vojtechsisma/vmix-tally/case/tally3_foot.stl

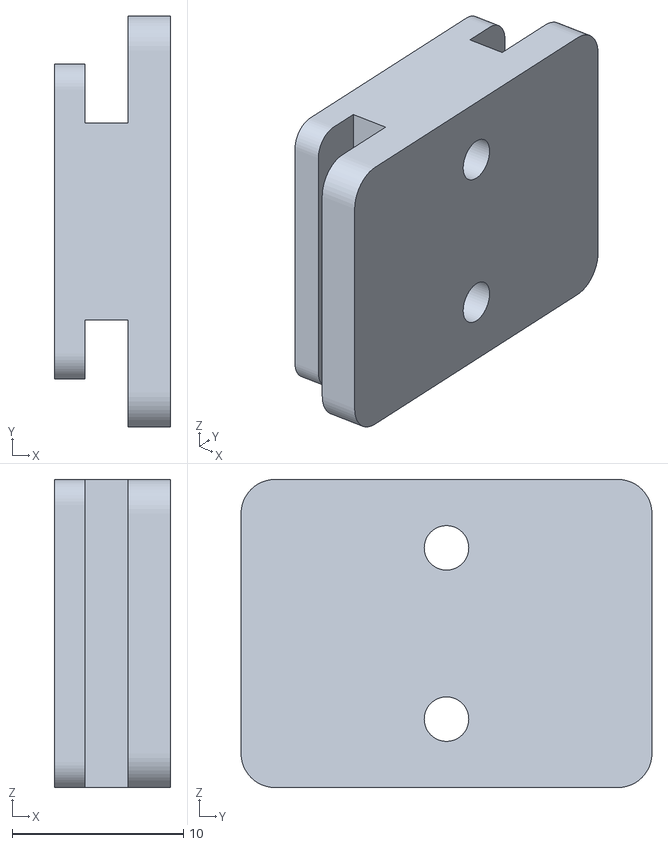
[picture p2: CAD file, 2026-11-11]
case/tally3_foot.stl
6.79 x 24.0 x 18.0
