vojtechsisma/vmix-tally/case/tally3_box.stl

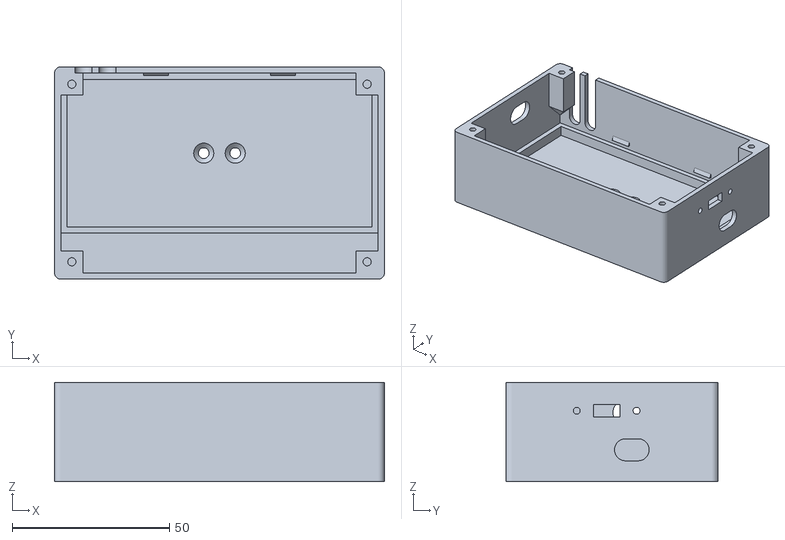
[picture p3: CAD file, 2026-11-11]
case/tally3_box.stl
104.8 x 67.4 x 31.5
