vojtechsisma/vmix-tally/case/tally3_lid.stl

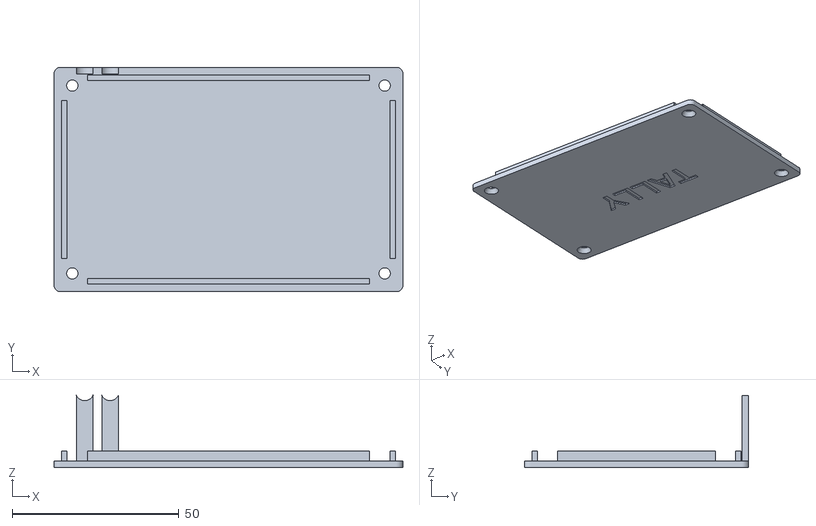
[picture p4: CAD file, 2026-11-11]
case/tally3_lid.stl
104.8 x 67.4 x 21.8
