vojtechsisma/vmix-tally/schematics/vmix_tally_18650.pdf

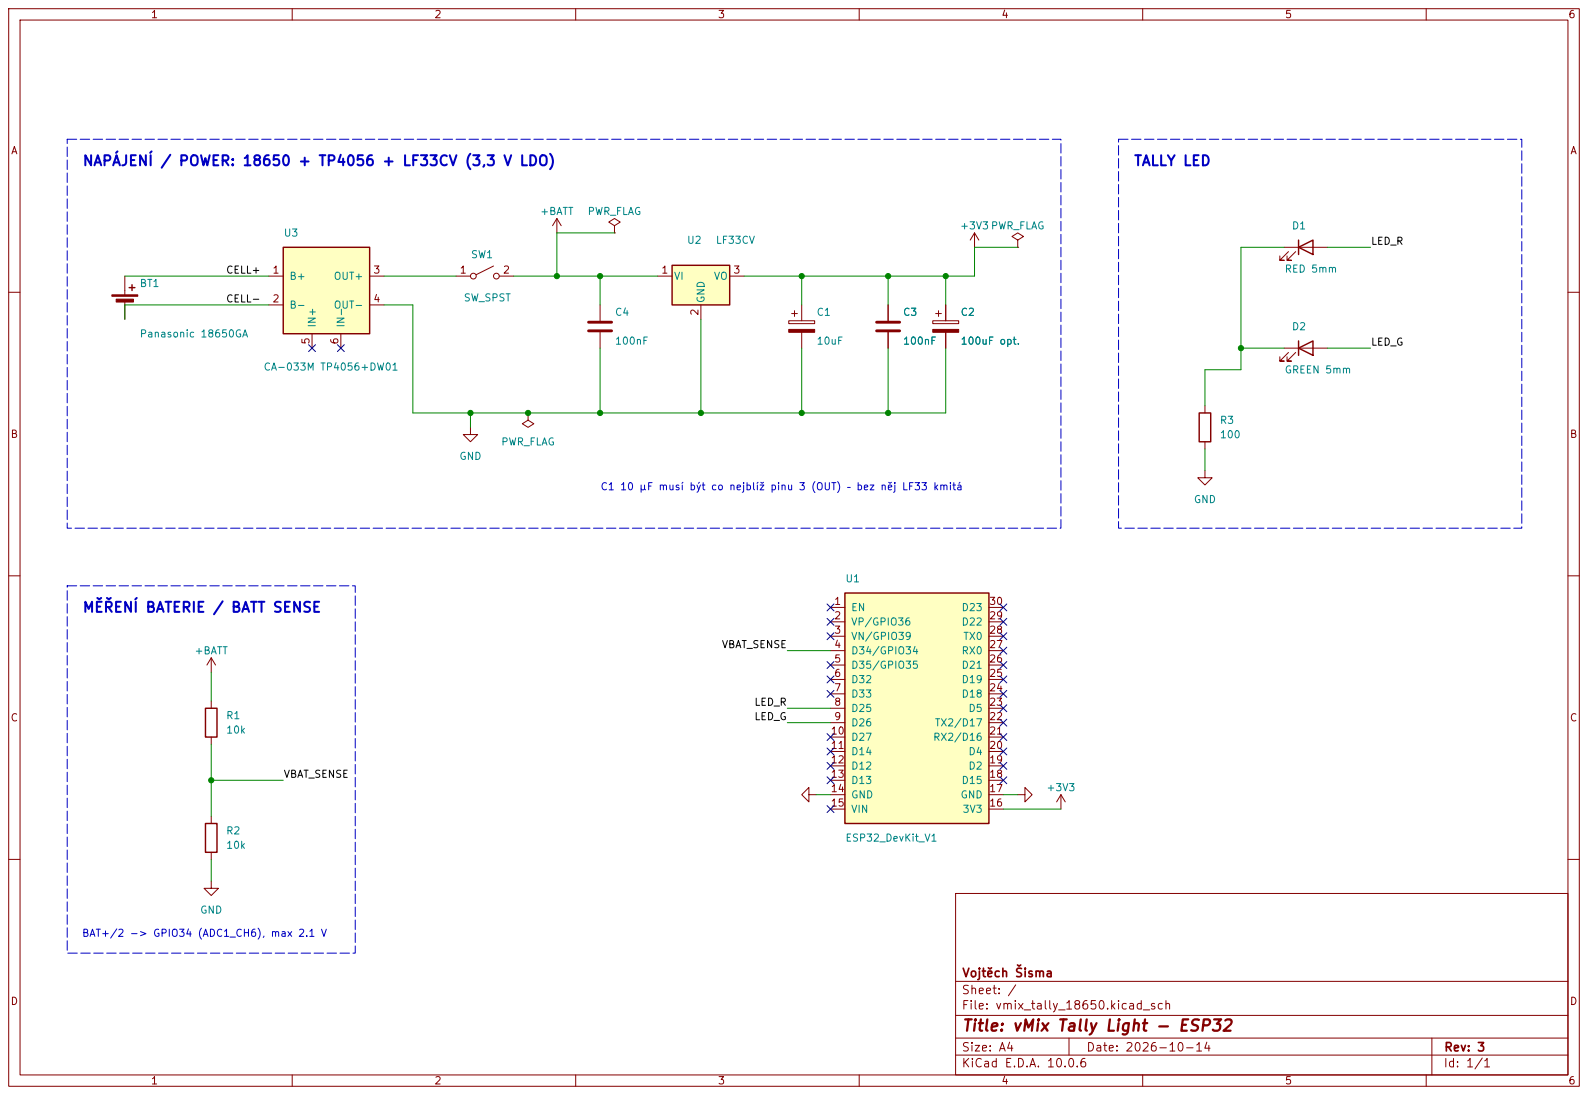
[picture p5: page 1]

MĚŘENÍ BATERIE / BATT SENSE

Vojtěch Šisma
Sheet: /
File: vmix_tally_18650.kicad_sch
Title: vMix Tally Light - ESP32

Size: A4 | Rev: 3
KiCad E.D.A. 10.0.6 | Id: 1/1
