vojtechsisma/vmix-tally/schematics/vmix_tally_18650.kicad_pcb

## KiCad design schematics/vmix_tally_18650.kicad_pcb (2026-10-14)

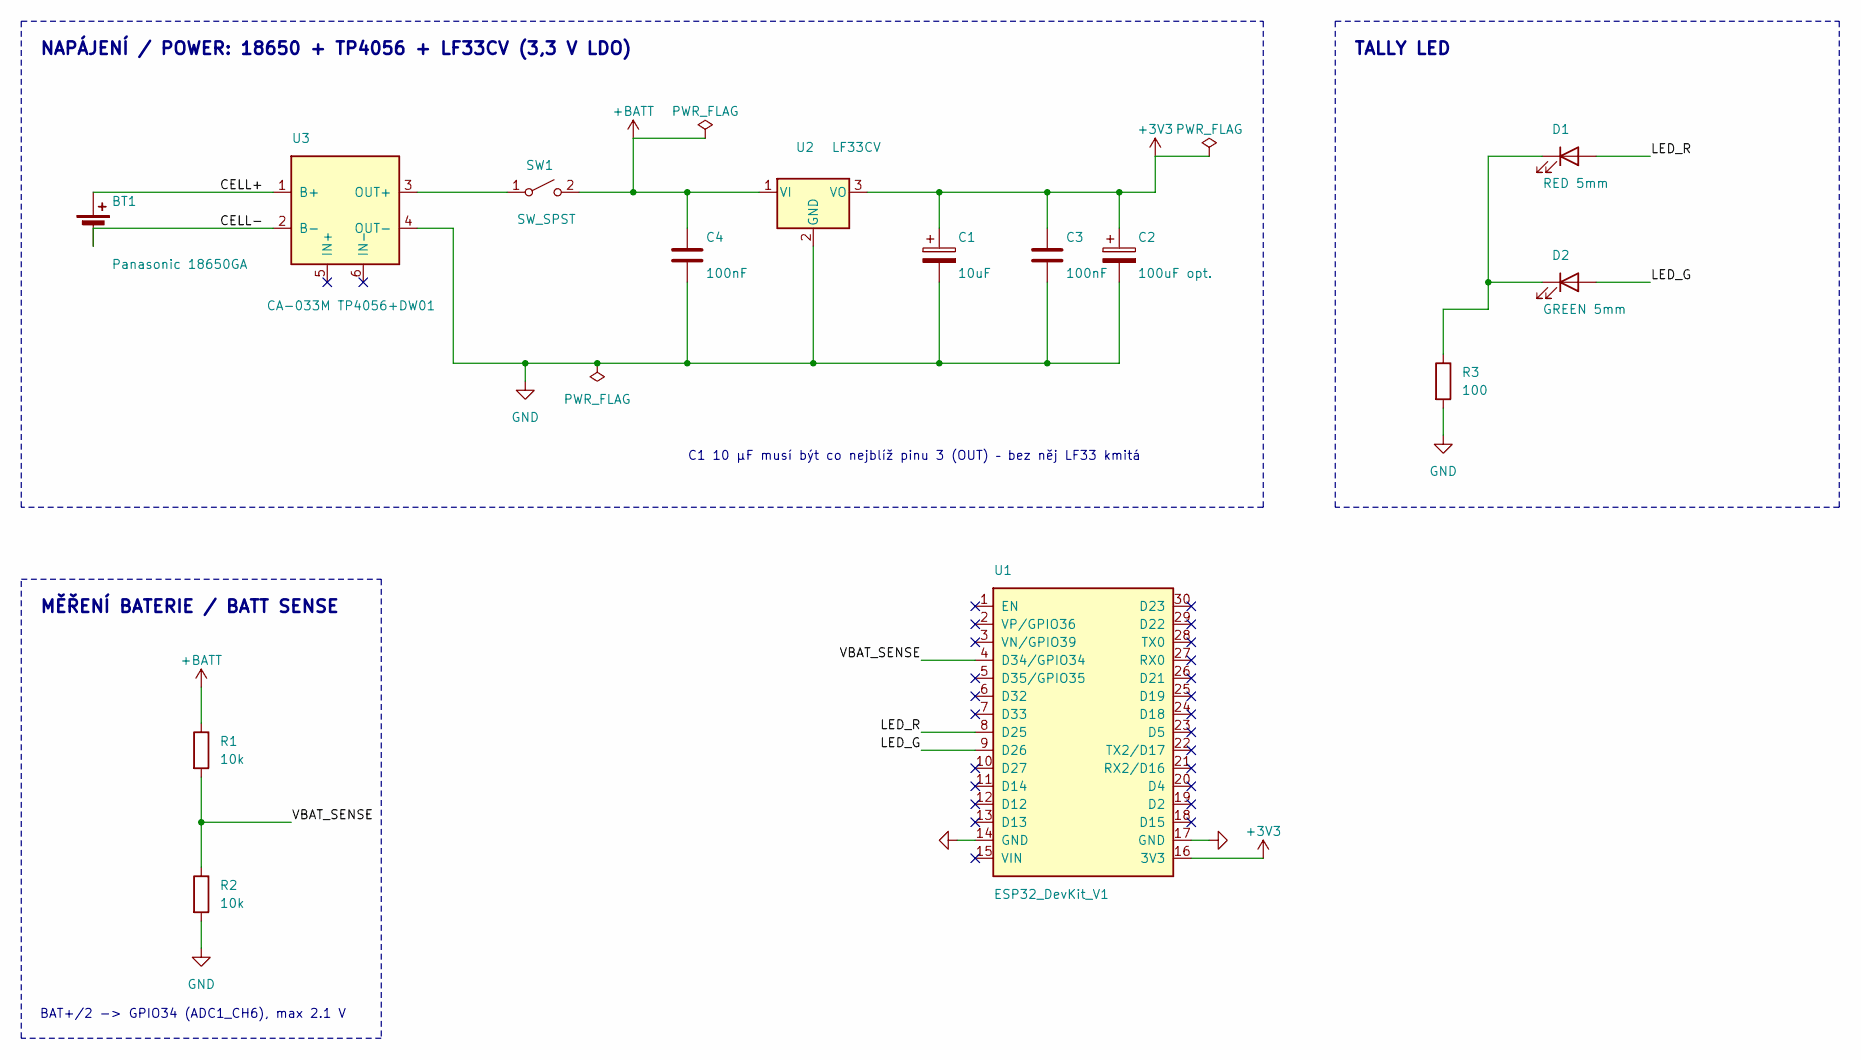
[picture p6: schematic vmix_tally_18650.kicad_sch, vMix Tally Light - ESP32]

Parts:
BT1: Panasonic 18650GA; SolderWire-0.5sqmm_1x02_P4.6mm_D0.9mm_OD2.1mm
C1: 10uF; CP_Radial_D5.0mm_P2.00mm
C2: 100uF opt.; CP_Radial_D5.0mm_P2.50mm
C3, C4: 100nF; C_Disc_D5.0mm_W2.5mm_P2.50mm
D1: RED 5mm; LED_D5.0mm
D2: GREEN 5mm; LED_D5.0mm
R1, R2: 10k; R_Axial_DIN0207_L6.3mm_D2.5mm_P10.16mm_Horizontal
R3: 100; R_Axial_DIN0207_L6.3mm_D2.5mm_P10.16mm_Horizontal
SW1: SW_SPST; SolderWire-0.5sqmm_1x02_P4.6mm_D0.9mm_OD2.1mm
U1: ESP32_DevKit_V1; ESP32_DevKit_V1_30pin_Socket
U2: LF33CV; TO-220-3_Vertical
U3: CA-033M TP4056+DW01; TP4056_Module_Wires

Connections:
+3V3: C1.1, C2.1, C3.1, U1.16 (3V3), U2.3 (VO)
+BATT: C4.1, R1.1, SW1.2 (B), U2.1 (VI)
/CELL+: BT1.1 (+), U3.1 (B+)
/CELL-: BT1.2 (-), U3.2 (B-)
/LED_G: D2.2 (A), U1.9 (D26)
/LED_R: D1.2 (A), U1.8 (D25)
/VBAT_SENSE: R1.2, R2.1, U1.4 (D34/GPIO34)
GND: C1.2, C2.2, C3.2, C4.2, R2.2, R3.2, U1.14 (GND), U1.17 (GND), U2.2 (GND), U3.4 (OUT-)
unnamed: D1.1 (K), D2.1 (K), R3.1
unnamed: SW1.1 (A), U3.3 (OUT+)

Notes on the sheet:
C1 10 µF musí být co nejblíž pinu 3 (OUT) – bez něj LF33 kmitá
BAT+/2 -> GPIO34 (ADC1_CH6), max 2.1 V
NAPÁJENÍ / POWER: 18650 + TP4056 + LF33CV (3,3 V LDO)
TALLY LED
MĚŘENÍ BATERIE / BATT SENSE

Board: 2 copper layers, 14 parts (0 on the bottom side), 10 nets, no tracks yet.
