vojtechsisma/vmix-tally/(commit log)

2026-10-14 feat: update firmware for 18650 battery
2026-11-11 feat: add case model
    [tally3_box.stl, tally3_foot.stl, tally3_lid.stl, tally_box_v3.scad]
